MidlaneBro/2018Spring_NTUEE_CornerStone/report/流程圖.pptx

track.ino

track.h
Node控制
node.h
node
Bluetooth.h
ask_direction
RFID.h
直線循跡
rfid
MotorWriting
MotorInverter
send_byte
出軌停止

## Slide 2

track.h
Node控制：自走車在出發前，電腦便會利用演算法算出在每個Node需要做的動作(前進、右轉、左轉、倒退)，並透過藍芽以字串的形式傳給Arduino，爾後自走車在遇到Node的時候，便會根據該字串去決定該做什麼動作。
node.h
node：傳入0代表字串結尾，即到達終點，讀取最後一個RDIF並永久停止；傳入1的時候強迫直行0.5秒後再重新進入循跡，以防自走車來不及走出Node造成誤判；傳入2的時候根據自走車目前是前進還是後退，分別做直走右轉及後退左轉；傳入3的時候同樣根據自走車目前是前進還是後退，分別做直走左轉及後退右轉；傳入4的時候，讀取RFID值並進入倒退模式。
Bluetooth.h
ask_direcrtion：用藍芽接收一個字元
RFID.h
rfid：感測RFID晶片並獲取id
直線循跡：在沒有遇到Node的時候，便使用PID+α循跡方式以使自走車能沿黑線直行
出軌停止：當紅外線感測器讀到五個全白時，隔0.1秒會再讀一次，若仍是全白，代表自走車嚴重偏離軌跡，停止馬達運轉直到人為將其擺回線上
MotorWriting：用L298N控制左右馬達的運轉速度
MotorInverter：由於analogWrite只能寫0~255，為了讓MotorWriting可以輸入負值代表馬達反轉，故需要此函數
sent_byte：用藍芽傳送RFID的內容

## Slide 3

main.py

maze.py
getAction
node.py
setSuccessor
BT.py
do_connect
disconnect
score.py
reverseDir
Dijkstra
ndToPath
exhaustiveAttack
optimalPath
game_1
isEnd
addUID
serialReadByte
serialWrite

## Slide 4

maze.py
getAction：傳入前後方向回傳自走車動作
node.py
setSucessor：根據csv檔，為一node設定相鄰點
Dijkstra：演算法核心，給定兩node，回傳最快路徑之行動、所需時間及完成後之方向
ndToPath：給定一node序列，回傳所需時間與最快路徑(exhaustiveAttack用)
exhaustiveAttack：給定一node集合，窮舉並給出最佳解之行動(optimalPath用)
optimalPath：給定一node集合，算出通過所有點之最快路徑的所需時間、自走車行動、經過node的順序(game_1用)
game_1：用以計算能在限時內獲得最多分數之路徑行動
isEnd：檢查一node是否為端點(maze.py之game_1用)
BT.py
do_connect：檢查藍芽是否已經連線
disconnect：斷開藍芽連線
serialWrite：將一字元以utf-8編碼並傳輸
serialReadByte：將Arduino回傳的UID序列轉為16進位字串
score.py
addUID：將傳入字串轉為int，檢查是否valid，若是則計算分數
