MidlaneBro/2018Spring_NTUEE_CornerStone/code/python_file/final/demo/36512501_2058166670884698_3856549146232094720_n.png

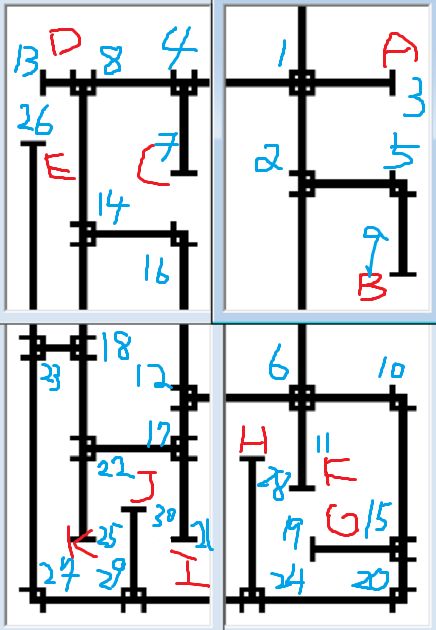
code/python_file/final/demo/36512501_2058166670884698_3856549146232094720_n.png
