MidlaneBro/2018Spring_NTUEE_CornerStone/code/python_file/final/data/test_dis_20180502.csv

index | North | South | West | East | dis_N | dis_S | dis_W | dis_E
1 |  | 2 | 4 |  |  | 1 | 2
2 | 1 | 3 | 5 |  | 1 | 2 | 2
3 | 2 |  |  |  | 2
4 |  | 5 |  | 1 |  | 1 |  | 2
5 | 4 |  | 7 | 2 | 1 |  | 1 | 2
6 |  | 7 |  |  |  | 2
7 | 6 | 8 |  | 5 | 2 | 2 |  | 1
8 | 7 |  |  | 9 | 2 |  |  | 2
9 |  |  | 8 |  |  |  | 2
