MidlaneBro/2018Spring_NTUEE_CornerStone/code/python_file/final/BT.py

from time import sleep
import serial
# these codes are for bluetooth
# hint: please check the function "sleep". how does it work?

class bluetooth:
    def __init__(self):
        self.ser = serial.Serial()

    def do_connect(self,port):
        self.ser.close()
        #TODO: Connect the port with Serial. A clear description for exception may be helpful.
        self.ser = serial.Serial(port,9600,timeout=2)
        if(self.ser.is_open):
            return True
        else:
            return False

    def disconnect(self):
        self.ser.close()

    def SerialWrite(self,output):
        send = output.encode("utf-8")
        self.ser.write(send)

    def SerialReadString(self):
        #TODO: Get the information from Bluetooth. Notice that the return type should be transformed into hex.
        sleep(0.01)
        if(self.ser.in_waiting!=0):
            rv=self.ser.readline()
        return rv.hex()

    def SerialReadByte(self):
        #TODO: Get the UID from bytes. Notice that the return type should be transformed into hex.
        sleep(0.01)
        if(self.ser.in_waiting!=0):
            rv=self.ser.readline()
        return rv.hex()
        return 0
